LedgerProject/disemin-weather-station/media/ws2.png

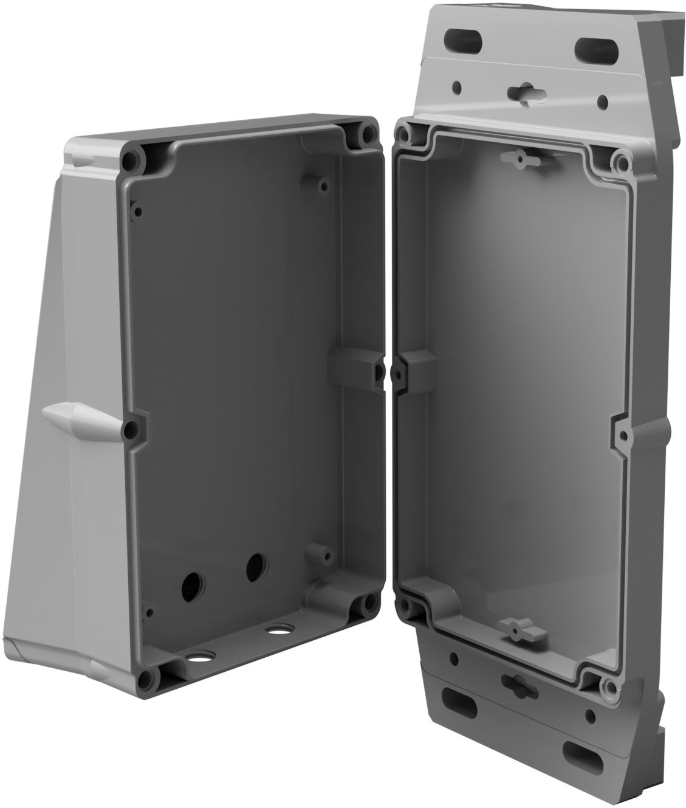
media/ws2.png
