LedgerProject/disemin-weather-station/media/ws3.png

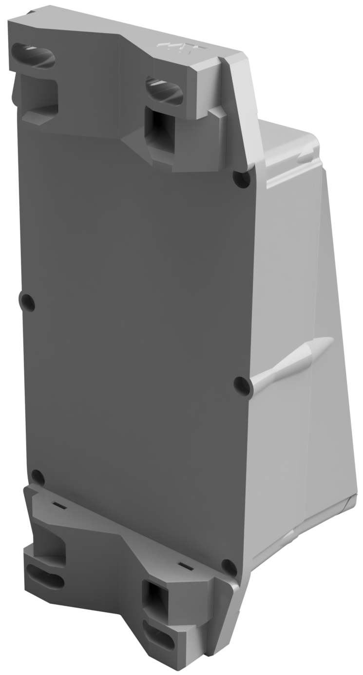
media/ws3.png
