LedgerProject/disemin-weather-station/media/ws4.png

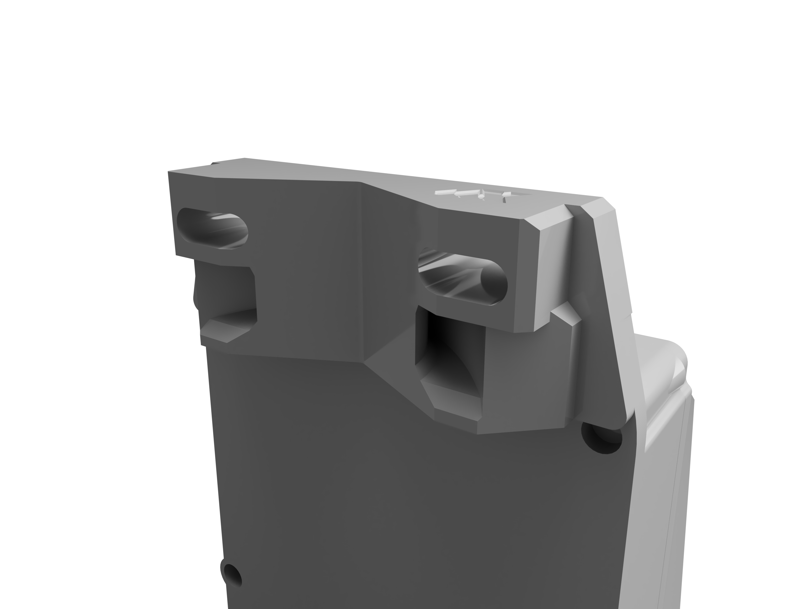
media/ws4.png
