LedgerProject/disemin-weather-station/pcb/schematic.pdf

### BME280 Module (i2c mode)

### Generic AHT10 module

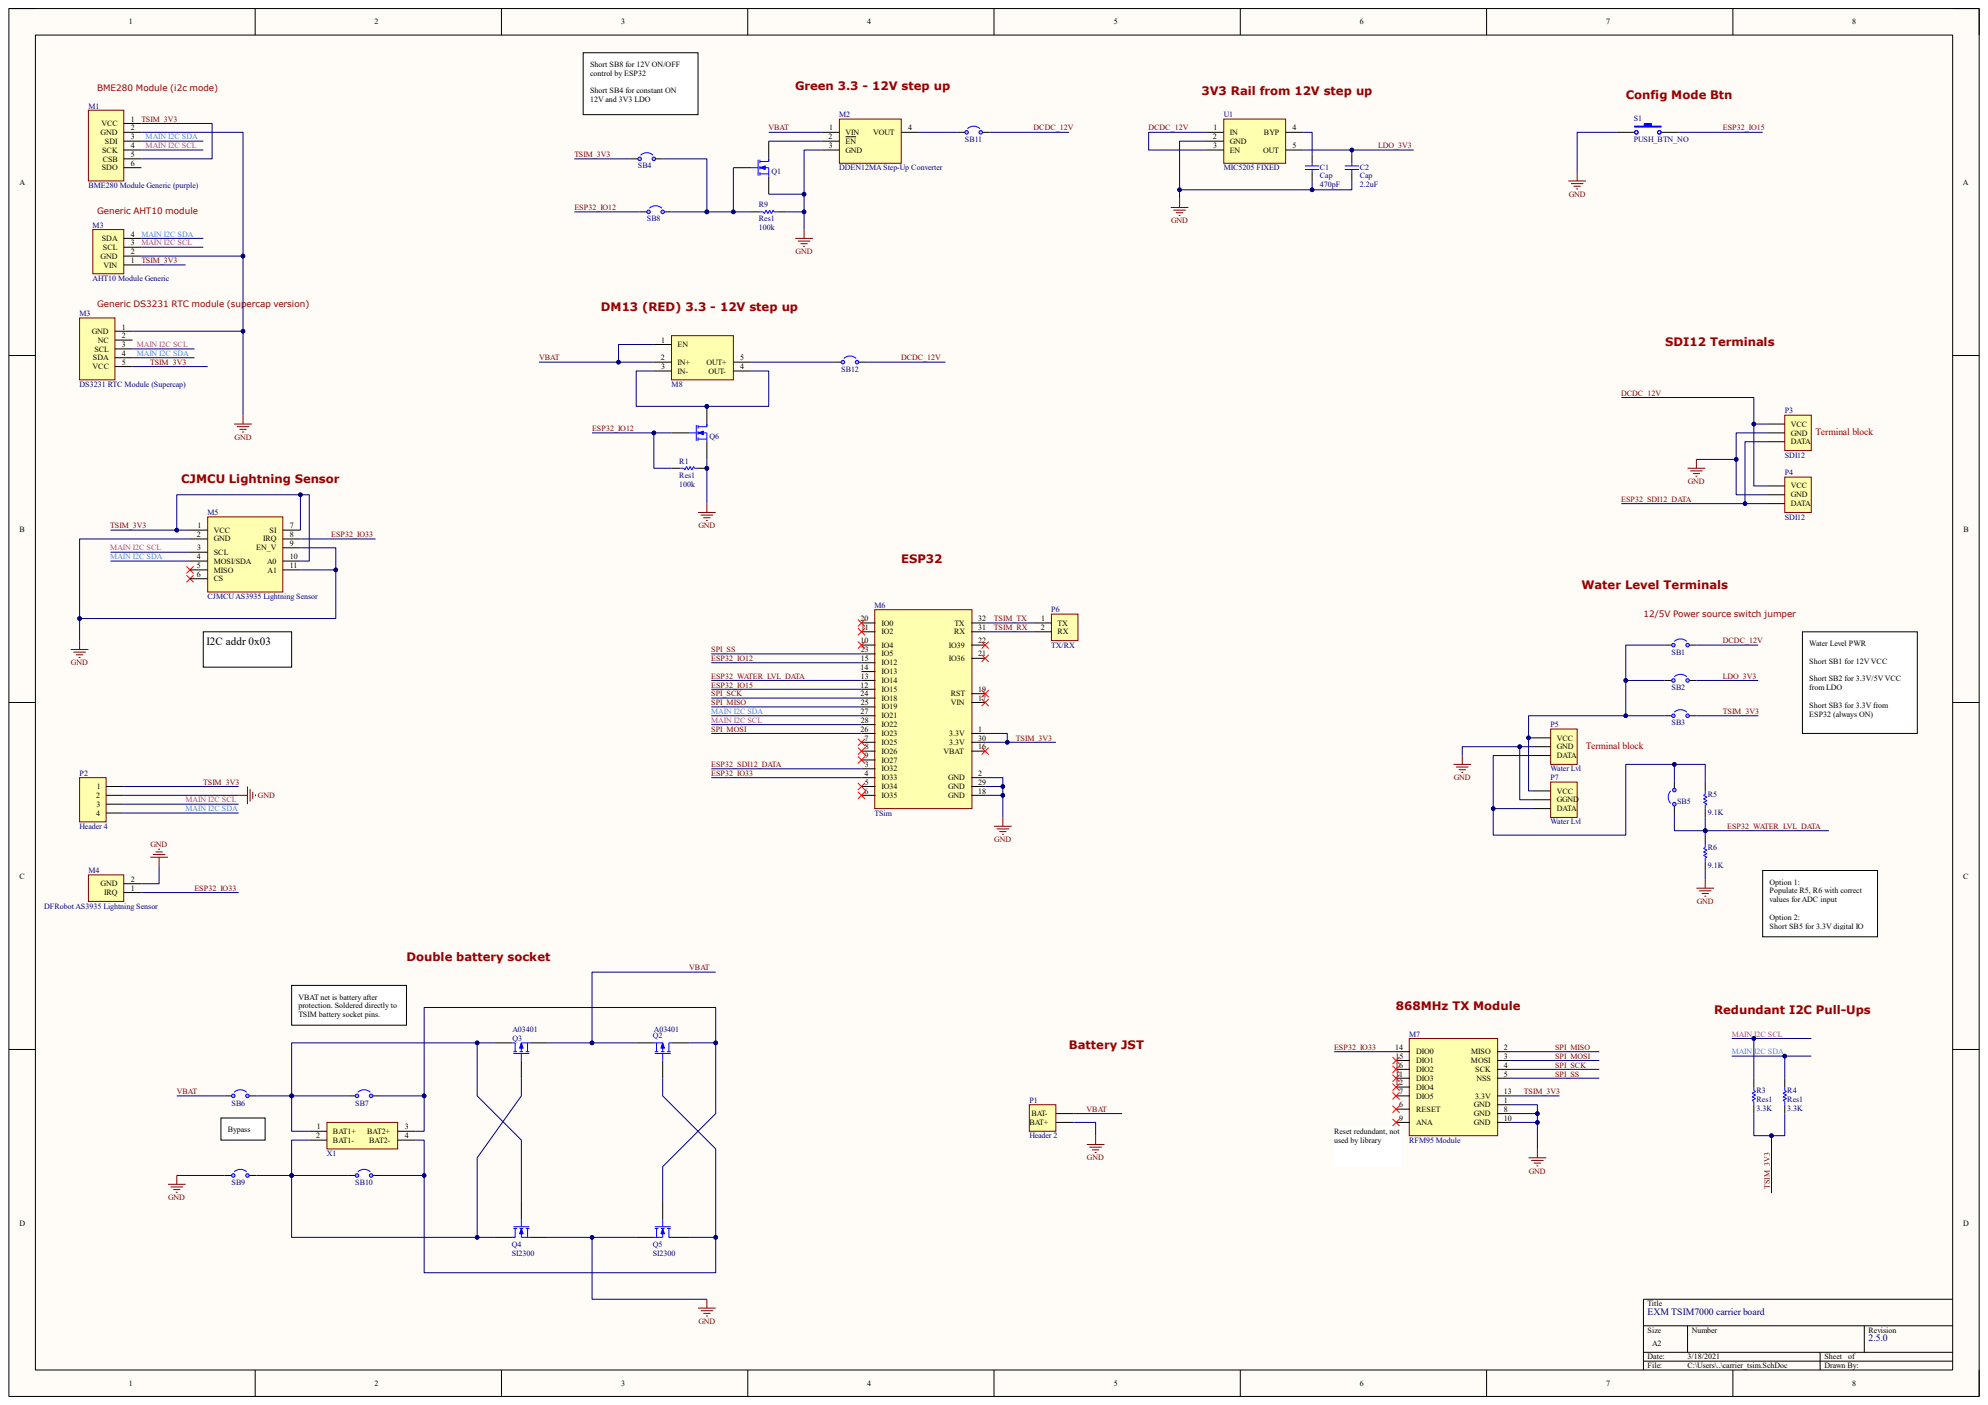
[picture p7: page 1]

Short SB8 for 12V ON/OFF
control by ESP32

Short SB4 for constant ON
12V and 3V3 LDO

3V3 Rail from 12V step up

Generic DS3231 RTC module (supercap version)

12/5V Power source switch jumper

Option 1:
Populate R5, R6 with correct
values for ADC input

Option 2:
Short SB5 for 3.3V digital IO

VBAT net is battery after
protection. Soldered directly to
TSIM battery socket pins.

Redundant I2C Pull-Ups 868MHz TX Module
