LedgerProject/disemin-weather-station/firmware/include/credentials.h

#ifndef CREDENTIALS_H
#define CREDENTIALS_H

#include "struct.h"

/**
 * Fallback TB device token. Used when not set in DeviceConfig
 */
const char FALLBACK_TB_DEVICE_TOKEN[] = "";

/**
 * Fallback cellular provider APN. Used when not set in DeviceConfig
 */
const char FALLBACK_CELL_APN[] = "";

/**
 * DEBUG build credentials
 */
#ifdef DEBUG

//
// Thingsboard
//
/** Thingsboard server URL */
const char TB_SERVER[] = "";
/** Thingsboard server port */
const int TB_PORT = 80;

//
// Device geoash
// 
const char DEVICE_GEOHASH[] = "";

//
// IPFS
//
/** Node address */
const char IPFS_NODE_ADDR[] = "";
/** Node port */
const int IPFS_NODE_PORT = 5001;

//
// WiFi debug console
//
const char WIFI_ROOT_CA_CERTIFICATE[] = \
"-----BEGIN CERTIFICATE-----\n" \
"MIIElDCCA3ygAwIBAgIQAf2j627KdciIQ4tyS8+8kTANBgkqhkiG9w0BAQsFADBh\n" \
"MQswCQYDVQQGEwJVUzEVMBMGA1UEChMMRGlnaUNlcnQgSW5jMRkwFwYDVQQLExB3\n" \
"d3cuZGlnaWNlcnQuY29tMSAwHgYDVQQDExdEaWdpQ2VydCBHbG9iYWwgUm9vdCBD\n" \
"QTAeFw0xMzAzMDgxMjAwMDBaFw0yMzAzMDgxMjAwMDBaME0xCzAJBgNVBAYTAlVT\n" \
"MRUwEwYDVQQKEwxEaWdpQ2VydCBJbmMxJzAlBgNVBAMTHkRpZ2lDZXJ0IFNIQTIg\n" \
"U2VjdXJlIFNlcnZlciBDQTCCASIwDQYJKoZIhvcNAQEBBQADggEPADCCAQoCggEB\n" \
"ANyuWJBNwcQwFZA1W248ghX1LFy949v/cUP6ZCWA1O4Yok3wZtAKc24RmDYXZK83\n" \
"nf36QYSvx6+M/hpzTc8zl5CilodTgyu5pnVILR1WN3vaMTIa16yrBvSqXUu3R0bd\n" \
"KpPDkC55gIDvEwRqFDu1m5K+wgdlTvza/P96rtxcflUxDOg5B6TXvi/TC2rSsd9f\n" \
"/ld0Uzs1gN2ujkSYs58O09rg1/RrKatEp0tYhG2SS4HD2nOLEpdIkARFdRrdNzGX\n" \
"kujNVA075ME/OV4uuPNcfhCOhkEAjUVmR7ChZc6gqikJTvOX6+guqw9ypzAO+sf0\n" \
"/RR3w6RbKFfCs/mC/bdFWJsCAwEAAaOCAVowggFWMBIGA1UdEwEB/wQIMAYBAf8C\n" \
"AQAwDgYDVR0PAQH/BAQDAgGGMDQGCCsGAQUFBwEBBCgwJjAkBggrBgEFBQcwAYYY\n" \
"aHR0cDovL29jc3AuZGlnaWNlcnQuY29tMHsGA1UdHwR0MHIwN6A1oDOGMWh0dHA6\n" \
"Ly9jcmwzLmRpZ2ljZXJ0LmNvbS9EaWdpQ2VydEdsb2JhbFJvb3RDQS5jcmwwN6A1\n" \
"oDOGMWh0dHA6Ly9jcmw0LmRpZ2ljZXJ0LmNvbS9EaWdpQ2VydEdsb2JhbFJvb3RD\n" \
"QS5jcmwwPQYDVR0gBDYwNDAyBgRVHSAAMCowKAYIKwYBBQUHAgEWHGh0dHBzOi8v\n" \
"d3d3LmRpZ2ljZXJ0LmNvbS9DUFMwHQYDVR0OBBYEFA+AYRyCMWHVLyjnjUY4tCzh\n" \
"xtniMB8GA1UdIwQYMBaAFAPeUDVW0Uy7ZvCj4hsbw5eyPdFVMA0GCSqGSIb3DQEB\n" \
"CwUAA4IBAQAjPt9L0jFCpbZ+QlwaRMxp0Wi0XUvgBCFsS+JtzLHgl4+mUwnNqipl\n" \
"5TlPHoOlblyYoiQm5vuh7ZPHLgLGTUq/sELfeNqzqPlt/yGFUzZgTHbO7Djc1lGA\n" \
"8MXW5dRNJ2Srm8c+cftIl7gzbckTB+6WohsYFfZcTEDts8Ls/3HB40f/1LkAtDdC\n" \
"2iDJ6m6K7hQGrn2iWZiIqBtvLfTyyRRfJs8sjX7tN8Cp1Tm5gr8ZDOo0rwAhaPit\n" \
"c+LJMto4JQtV05od8GiG7S5BNO98pVAdvzr508EIDObtHopYJeS4d60tbvVS3bR0\n" \
"j6tJLp07kzQoH3jOlOrHvdPJbRzeXDLz\n" \
"-----END CERTIFICATE-----\n";

/** Wifi SSID */
const char WIFI_SSID[] = "";
/** Wifi password */
const char WIFI_PASSWORD[] = "";
/** Timber.io log source id */
#define TIMBER_SOURCE_ID ""
#define TIMBER_API_KEY ""

// const char TIMBER_API_URL = ""

/**
 * RELEASE build credentials
 */
#elif RELEASE
//
// Thingsboard
//
/** Thingsboard server URL */
// const char TB_SERVER[] = "iot.exm.gr";
const char TB_SERVER[] = "";
// const char TB_SERVER[] = "iot.exm.gr";
/** Thingsboard server port */
const int TB_PORT = 80;

//
// Device geoash
// 
const char DEVICE_GEOHASH[] = "";

//
// IPFS
//
/** Node address */
const char IPFS_NODE_ADDR[] = "";
/** Node port */
const int IPFS_NODE_PORT = 80;

/** Wifi SSID */
const char WIFI_SSID[] = "";
/** Wifi password */
const char WIFI_PASSWORD[] = "";
/** Timber.io log source id */
#define TIMBER_SOURCE_ID ""
#define TIMBER_API_KEY ""

#else
#error "No build type specified."
#endif

#endif // CREDENTIALS_H`
